x893/openmv/eagle/openmv1/OpenMV-2L.brd

## EAGLE design eagle/openmv1/OpenMV-2L.brd (2016-07-31)

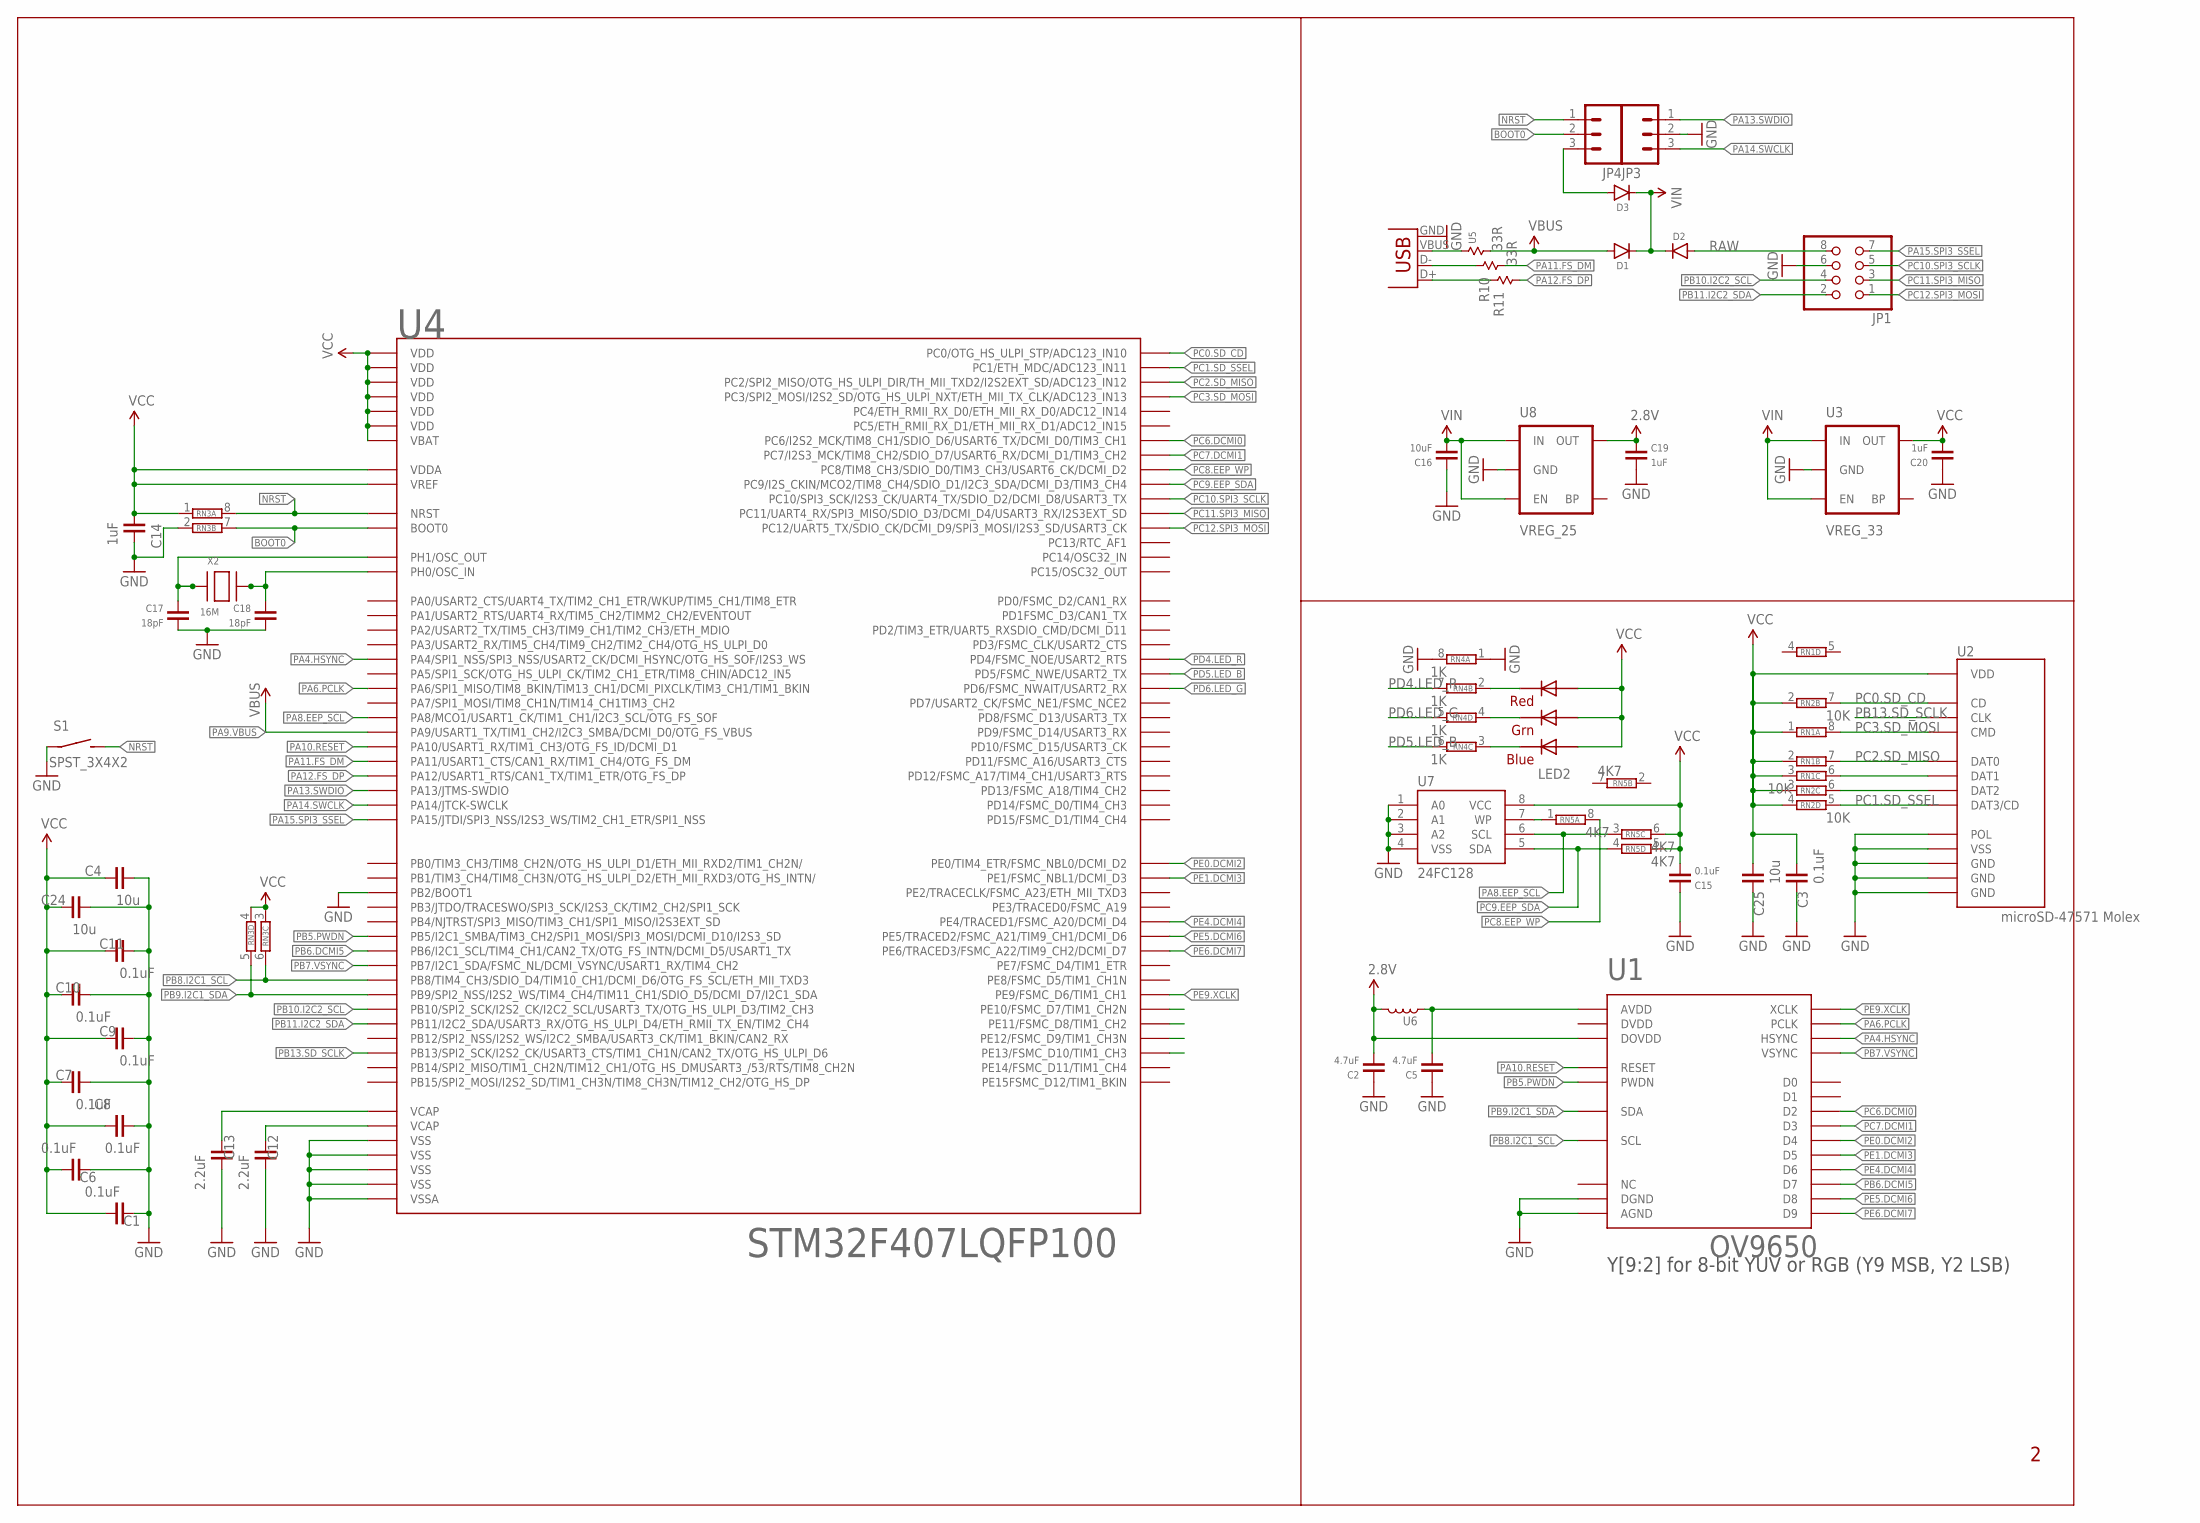
[picture p1: schematic OpenMV-2L.sch]

Parts:
C1, C3, C6, C7, C8, C9, C10, C11: 0.1uF; 0402
C2, C5: 4.7uF; 0603
C4, C24, C25: 10u; 0805
C12, C13: 2.2uF; 0402
C14: 1uF; 0402
C15: 0.1uF; 0603
C16: 10uF; 0805
C17, C18: 18pF; 0402
C19, C20: 1uF; 0603
D1, D2, D3: DIODE-SOD-323; SOD-323
JP1: PINHD-2X4; 2X04
JP3, JP4: M03PTH; 1X03
LED2: RGBLED5050
R10, R11: 33R; 0402
RN1, RN3: 4R-NCAT16; CAT16
RN2: 10K; CAT16
RN4: 1K; CAT16
RN5: 4K7; CAT16
S1: SPST_3X4X2; 3X4X2TACT
U1: OV9650
U2: microSD-47571 Molex; USD-47571
U3: VREG_33; SOT23-5
U4: STM32F407LQFP100; LQFP100
U5: RESISTOR-0402; 0402
U6: INDUCTOR-0603; 0603
U7: 24FC128; MSOP8
U8: VREG_25; SOT23-5
X1: USB-MICROB
X2: 16M; NX5032

Connections:
2.8V: C2.1, C19.2, U1.P$11 (DOVDD), U6.2, U8.5 (OUT)
BOOT0: JP4.2, RN3.7 (2), U4.94 (BOOT0)
GND: C1.1, C2.2, C3.2, C4.1, C5.2, C6.1, C7.2, C8.1, C9.2, C10.2, C11.2, C12.2, C13.2, C14.1, C15.2, C16.2, C17.1, C18.1, C19.1, C20.2, C24.1, C25.2, JP1.6, JP3.2, RN3.2 (1), RN4.1, RN4.8 (2), S1.P$1, U1.P$2 (AGND), U1.P$15 (DGND), U2.G$1 (GND), U2.G$2 (GND), U2.G$3 (GND), U2.G$4 (POL), U2.P$6 (VSS), U3.2 (GND), U4.10 (VSS), U4.20 (VSSA), U4.27 (VSS), U4.37 (PB2/BOOT1), U4.74 (VSS), U4.99 (VSS), U7.1 (A0), U7.2 (A1), U7.3 (A2), U7.4 (VSS), U8.2 (GND), X1.GND
unnamed: RN1.6 (2), U2.P$8 (DAT1)
unnamed: RN2.6 (2), U2.P$1 (DAT2)
unnamed: LED2.5 (RED_C), RN4.2 (1)
unnamed: LED2.6 (GREEN_C), RN4.4 (1)
unnamed: LED2.4 (BLUE_C), RN4.3 (1)
unnamed: C17.2, U4.13 (PH1/OSC_OUT), X2.P$1
unnamed: C18.2, U4.12 (PH0/OSC_IN), X2.P$2
unnamed: RN5.1, U7.7 (WP)
unnamed: C5.1, U1.P$4 (AVDD), U6.1
unnamed: D3.2 (A), JP4.3
unnamed: R10.1, X1.D-
unnamed: R11.1, X1.D+
unnamed: U5.1, X1.VBUS
NRST: JP4.1, RN3.8 (2), S1.P$2 (S), U4.14 (NRST)
PA4.HSYNC: U1.P$9 (HSYNC), U4.29 (PA4/SPI1_NSS/SPI3_NSS/USART2_CK/DCMI_HS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)
PA6.PCLK: U1.P$17 (PCLK), U4.31 (PA6/SPI1_MISO/TIM8_BKIN/TIM13_CH1/DCMI_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)
PA8.EEP_SCL: RN5.3 (1), U4.67 (PA8/MCO1/USART1_CK/TIM1_CH1/I2C3_SCL/OT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), U7.6 (SCL)
PA9.VBUS: D1.2 (A), U4.68 (PA9/USART1_TX/TIM1_CH2/I2C3_SMBA/DCMI_D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), U5.2
PA10.RESET: U1.P$6 (RESET), U4.69 (PA10/USART1_RX/TIM1_CH3/OTG_FS_ID/DCMI_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)
PA11.FS_DM: R10.2, U4.70 (PA11/USART1_CTS/CAN1_RX/TIM1_CH4/OTG_FS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)
PA12.FS_DP: R11.2, U4.71 (PA12/USART1_RTS/CAN1_TX/TIM1_ETR/OTG_FS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)
PA13.SWDIO: JP3.1, U4.72 (PA13/JTMS-SWDIO)
PA14.SWCLK: JP3.3, U4.76 (PA14/JTCK-SWCLK)
PA15.SPI3_SSEL: JP1.7, U4.77 (PA15/JTDI/SPI3_NSS/I2S3_WS/TIM2_CH1_ETR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)
PB5.PWDN: U1.P$8 (PWDN), U4.91 (PB5/I2C1_SMBA/TIM3_CH2/SPI1_MOSI/SPI3_M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)
PB6.DCMI5: U1.P$16 (D7), U4.92 (PB6/I2C1_SCL/TIM4_CH1/CAN2_TX/OTG_FS_IN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)
PB7.VSYNC: U1.P$7 (VSYNC), U4.93 (PB7/I2C1_SDA/FSMC_NL/DCMI_VSYNC/USART1_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)
PB8.I2C1_SCL: RN3.6 (2), U1.P$5 (SCL), U4.95 (PB8/TIM4_CH3/SDIO_D4/TIM10_CH1/DCMI_D6/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)
PB9.I2C1_SDA: RN3.5 (2), U1.P$3 (SDA), U4.96 (PB9/SPI2_NSS/I2S2_WS/TIM4_CH4/TIM11_CH1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)
PB10.I2C2_SCL: JP1.4, U4.47 (PB10/SPI2_SCK/I2S2_CK/I2C2_SCL/USART3_T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)
PB11.I2C2_SDA: JP1.2, U4.48 (PB11/I2C2_SDA/USART3_RX/OTG_HS_ULPI_D4/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)
PB13.SD_SCLK: U2.P$5 (CLK), U4.52 (PB13/SPI2_SCK/I2S2_CK/USART3_CTS/TIM1_C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)
PC0.SD_CD: RN2.7 (2), U2.G$5 (CD), U4.15 (PC0/OTG_HS_ULPI_STP/ADC123_IN10)
PC1.SD_SSEL: RN2.5 (2), U2.P$2 (DAT3/CD), U4.16 (PC1/ETH_MDC/ADC123_IN11)
PC2.SD_MISO: RN1.7 (2), U2.P$7 (DAT0), U4.17 (PC2/SPI2_MISO/OTG_HS_ULPI_DIR/TH_MII_TX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)
PC3.SD_MOSI: RN1.8 (2), U2.P$3 (CMD), U4.18 (PC3/SPI2_MOSI/I2S2_SD/OTG_HS_ULPI_NXT/E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)
PC6.DCMI0: U1.P$19 (D2), U4.63 (PC6/I2S2_MCK/TIM8_CH1/SDIO_D6/USART6_TX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)
PC7.DCMI1: U1.P$21 (D3), U4.64 (PC7/I2S3_MCK/TIM8_CH2/SDIO_D7/USART6_RX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)
PC8.EEP_WP: RN5.8 (2), U4.65 (PC8/TIM8_CH3/SDIO_D0/TIM3_CH3/USART6_CK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)
PC9.EEP_SDA: RN5.4 (1), U4.66 (PC9/I2S_CKIN/MCO2/TIM8_CH4/SDIO_D1/I2C3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), U7.5 (SDA)
PC10.SPI3_SCLK: JP1.5, U4.78 (PC10/SPI3_SCK/I2S3_CK/UART4_TX/SDIO_D2/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)
PC11.SPI3_MISO: JP1.3, U4.79 (PC11/UART4_RX/SPI3_MISO/SDIO_D3/DCMI_D4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)
PC12.SPI3_MOSI: JP1.1, U4.80 (PC12/UART5_TX/SDIO_CK/DCMI_D9/SPI3_MOSI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)
PD4.LED_R: RN4.7 (2), U4.85 (PD4/FSMC_NOE/USART2_RTS)
PD5.LED_B: RN4.6 (2), U4.86 (PD5/FSMC_NWE/USART2_TX)
PD6.LED_G: RN4.5 (2), U4.87 (PD6/FSMC_NWAIT/USART2_RX)
PE0.DCMI2: U1.P$22 (D4), U4.97 (PE0/TIM4_ETR/FSMC_NBL0/DCMI_D2)
PE1.DCMI3: U1.P$20 (D5), U4.98 (PE1/FSMC_NBL1/DCMI_D3)
PE4.DCMI4: U1.P$18 (D6), U4.3 (PE4/TRACED1/FSMC_A20/DCMI_D4)
PE5.DCMI6: U1.P$14 (D8), U4.4 (PE5/TRACED2/FSMC_A21/TIM9_CH1/DCMI_D6)
PE6.DCMI7: U1.P$12 (D9), U4.5 (PE6/TRACED3/FSMC_A22/TIM9_CH2/DCMI_D7)
PE9.XCLK: U1.P$13 (XCLK), U4.40 (PE9/FSMC_D6/TIM1_CH1)
RAW: D2.2 (A), JP1.8
VCAP1: C13.1, U4.49 (VCAP)
VCAP2: C12.1, U4.73 (VCAP)
VCC: C1.2, C3.1, C4.2, C6.2, C7.1, C8.2, C9.1, C10.1, C11.1, C14.2, C15.1, C20.1, C24.2, C25.1, LED2.1 (GREEN_A), LED2.2 (RED_A), LED2.3 (BLUE_A), RN1.1, RN1.2 (1), RN1.3 (1), RN2.2 (1), RN2.3 (1), RN2.4 (1), RN3.1, RN3.3 (1), RN3.4 (1), RN5.5 (2), RN5.6 (2), U2.P$4 (VDD), U3.5 (OUT), U4.6 (VBAT), U4.11 (VDD), U4.19 (VDD), U4.21 (VREF), U4.22 (VDDA), U4.28 (VDD), U4.50 (VDD), U4.75 (VDD), U4.100 (VDD), U7.8 (VCC)
VIN: C16.1, D1.1 (C), D2.1 (C), D3.1 (C), U3.1 (IN), U3.3 (EN), U8.1 (IN), U8.3 (EN)

Notes on the sheet:
Y[9:2] for 8-bit YUV or RGB (Y9 MSB, Y2 LSB)

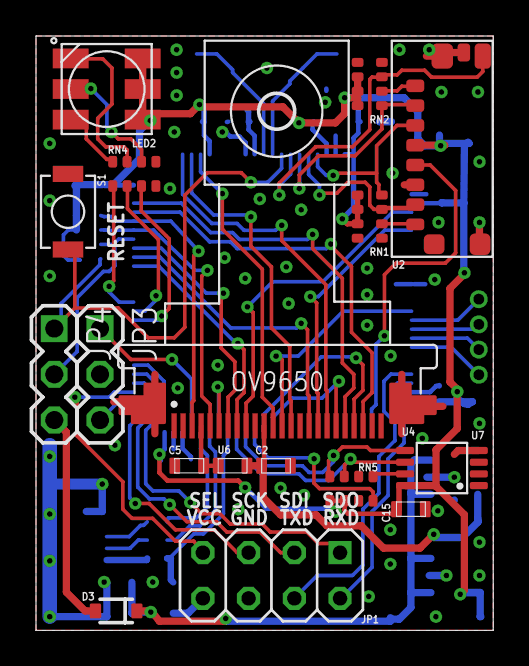
[picture p2: board OpenMV-2L.brd from above]

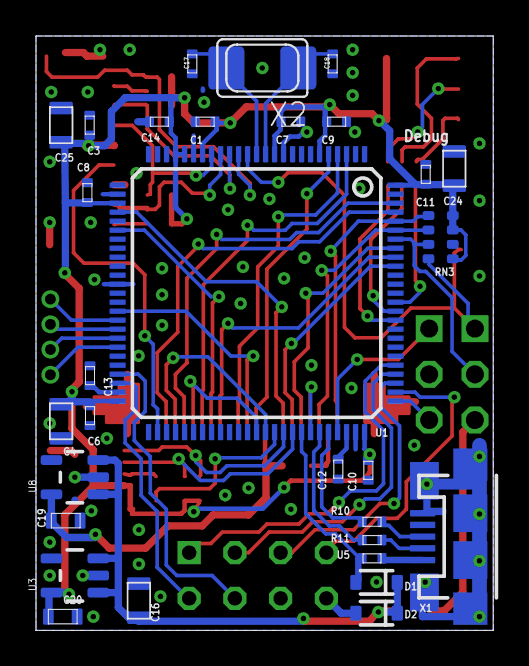
[picture p3: board OpenMV-2L.brd from below]

Board: 2 copper layers, 25.4 x 33.0 mm, 47 parts (30 on the bottom side), 60 nets.
