x893/openmv/(commit log)

2016-07-31 Change for OpenMV1
    [OpenMV-2L.brd, OpenMV-2L.sch]
2016-07-31 Change OpenMN1 with STM32F407VG
